David-Andrino/iot-power/README.md

# IoT - POWER

**David Andrino** 

**Estela Mora** 

**Fernando Sanz** 

**Hugo Sanchez**

Gemini_Generated_Image_dmnvikdmnvikdmnv
