David-Andrino/iot-power/memoria/files/3-Software/3-2-Modulos Software/3-2-2-Fichero_Hardware.tex

\subsubsection{Fichero Hardware.h}

El fichero \texttt{Hardware.h} define los pines que utiliza el \texttt{ESP}. 

Siendo estos pines:
\begin{itemize}
    \item \textbf{GPIO13 y GPIO15}: Para la gestión de la conmutación de los relés. 
    \item \textbf{GPIO4 y GPIO5}: Usados para la gestión de la comunicación \texttt{I2C} (Señales \texttt{SDA} y \texttt{SCL} respectivamente). 
\end{itemize}
