David-Andrino/iot-power/doxygen/main.md

# IoT - POWER

**David Andrino**

**Estela Mora**

**Fernando Sanz**

**Hugo Sánchez**

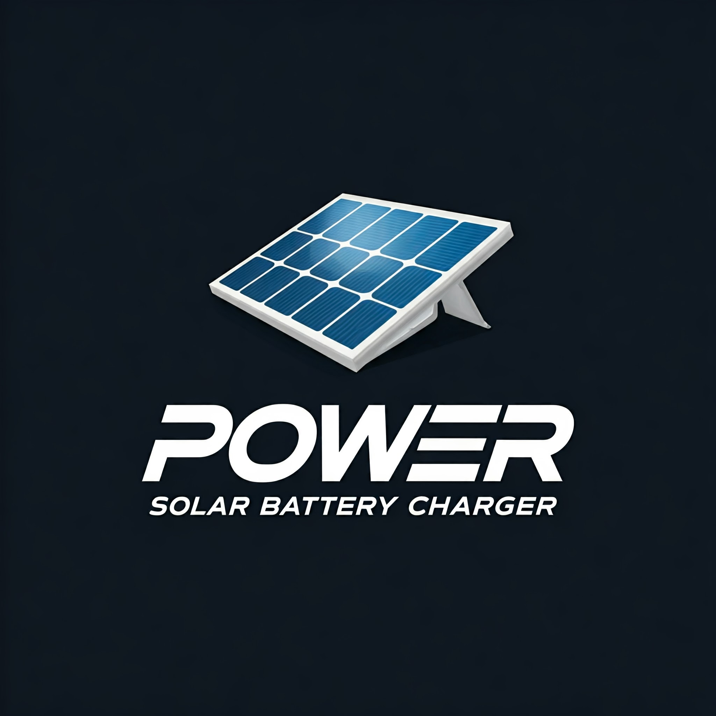
[picture p10: doxygen/logo_full.jpg]
