David-Andrino/iot-power/memoria/cover.tex

\begin{titlepage}
    \raggedleft
    \rule{1pt}{\textheight}
    \hspace{0.05\textwidth}
    \parbox[b]{0.9\textwidth}{
            {\Huge\bfseries POWER}\\[\baselineskip] % Title
            {\Large\textit{Photovoltaic Optimized Wireless Energy Recharger}}\\[7\baselineskip] % Subtitle or further description
        \vspace{0.45\textheight}
        
        {\Large\textsc{David Andrino}}\\[0.5\baselineskip]
        {\Large\textsc{Estela Mora}}\\[0.5\baselineskip]
        {\Large\textsc{Hugo Sánchez}}\\[0.5\baselineskip]
        {\Large\textsc{Fernando Sanz}}\\
        \vspace{0.05\textheight}
        
        {\noindent\large Hardware para IoT}\\
        {\noindent\large Otoño 2024}\\
    }

\end{titlepage}
