David-Andrino/iot-power/memoria/files/3-Software/3-3-Programa Principal/Programa Principal.tex

Este módulo está formado por el archivo, \texttt{MAIN\_POWER.ino} que se encarga de conectar todos los módulos en un sistema unificado.

Inicialmente, en la cabecera del fichero se incluyen las librerías que vamos a utilizar:
\begin{itemize}
    \item \texttt{telemetry.hpp}: Define la estructura de datos que será usada para almacenar las lecturas recibidas por los \texttt{INA}.
    \item \texttt{hardware-hpp}: Define los pines del \texttt{ESP} que son necesarias para el funcionamiento del sistema (I2C y relés).
    \item \texttt{ina.hpp}: Contiene el código relativo a la gestión, configuración y obtención de datos de los \texttt{INA}. 
    \item \texttt{mqtt\_client.hpp}: Contiene el código relativo a la conexión y envío de datos al servidor \texttt{MQTT}.
    \item \texttt{file\_management.hpp}: Contiene el código relativo a la escritura en un fichero de los datos recibidos de los \texttt{INA}.
    \item \texttt{sleep.hpp}: Contiene el código que pone en bajo consumo al \texttt{ESP}.
\end{itemize}

\begin{lstlisting}[captionpos=b, caption={Cabecera con los módulos y ficheros utilizados}, language=c++]
#include "telemetry.hpp"
#include "hardware.hpp"
#include "ina.hpp"
#include "mqtt_client.hpp"
#include "file_management.hpp"
#include "sleep.hpp"
\end{lstlisting}

A continuación, se define una macro para imprimir mensajes de depuración por \texttt{Serial}, si la variable \texttt{DEBUG} está definida.
\begin{lstlisting}[captionpos=b, caption={Definición de la macro de depuración}, language=c++]
#define DEBUG

#ifdef DEBUG
#define PRINT_DEBUG(...) Serial.println(__VA_ARGS__)
#else
#define PRINT_DEBUG(...)
#endif    
\end{lstlisting}

Esta macro se encarga de escribir por el puerto serie información de interés como:
\begin{itemize}
    \item Mostrar la información recibida por los \texttt{INA} (así corroborar la correcta recepción en el \texttt{MQTT}).
    \item Indicar si se ha podido enviar correctamente los datos al servidor \texttt{MQTT}.
    \item Indicar la hora recibida del \texttt{NTP}.
    \item Indicar la correcta conexión con la red \texttt{Wi-Fi}.
    \item Indicar si se ha podido escribir correctamente en el fichero que almacena los datos de medidas.
    \item Indicar el estado del proceso de conexión con la \texttt{WiFi}.
    \item Indicar las modificaciones en los relés y el estado en el que se encuentran.
\end{itemize}

Después de este código, se encuentra la definición de distintos elementos utilizados por el \texttt{main}:
\begin{lstlisting}[captionpos=b, caption={Constantes de \texttt{MAIN\_POWER}}, language=c++]
#define ssid             "POC"
#define password         "POWERIoT"

#define MQTT_SERVER      const_cast<char*>("192.168.111.69")
#define MQTT_PORT        4444

#define TIME_SLEEP       10000
#define WIFI_TRIES       35
#define BAT_THRESH       11.8
#define SOLAR_THRESH     20
#define MEASUREMENT_FILE "/measurements.txt"
\end{lstlisting}

\begin{itemize}
    \item \texttt{SSID y password}: Son utilizados para indicar el \texttt{SSID} de la Wi-Fi a la que conectarse y su contraseña. 
    \item \texttt{MQTT\_SERVER y MQTT\_PORT}: Indican la dirección y el puerto del servidor \texttt{MQTT} al que el \texttt{ESP} se intentará conectar para enviar datos.
    \item \texttt{TIME\_SLEEP}: Indica el tiempo en ms que se quedará en bajo consumo/dormido el sistema.
    \item \texttt{WIFI\_TIRES}: Indica el número de reintentos que damos al \texttt{ESP} para conectarse a la red \texttt{Wi-Fi}.
    \item \texttt{BAT\_THRESH}: Umbral de la batería de backup con el que el sistema determina si activa la protección de sobrecarga.
    \item \texttt{SOLAR\_THRESH}: Umbral del panel solar para el que el sistema determina si cambiamos a la carga mediante la batería de backup.
    \item \texttt{MEASUREMENT\_FILE}: Indica la ruta donde se almacena el fichero de medidas.
\end{itemize}

El fichero contiene las siguientes funciones:

\begin{itemize}
\item \texttt{setup()}: Inicializa los pines que usamos para la comunicación \texttt{I2C} y los relés, la velocidad del puerto serie y el valor inicial de la estructura de datos que contienen.

\begin{lstlisting}[captionpos=b, caption={Codigo de la funcion \texttt{setup}}, language=c++]
void setup() {
    pinMode(RELAY_SW_IN,  OUTPUT);
    pinMode(RELAY_SW_OUT, OUTPUT);
    pinMode(SDA,          OUTPUT);
    pinMode(SCL,          OUTPUT);

    Serial.begin(9600);
}    
\end{lstlisting}

\item \texttt{loop()}: Bucle principal de funcionamiento del sistema. La secuencia de ejecución es la siguiente:
\begin{enumerate}
    \item Recoge las medidas de los \texttt{INA}.
    \item Revisa los valores obtenidos de tensión y actúa sobre los relés.
    \item Se intenta conectar a la red \texttt{Wi-Fi}. Si lo consigue se intenta mandar las medidas al servidor \texttt{MQTT}.
    \item Guarda las medidas de los sensores en un fichero.
    \item Duerme al \texttt{ESP} poniéndolo en bajo consumo.
    \item Sale del modo de bajo consumo.
\end{enumerate}

\begin{lstlisting}[captionpos=b, caption={Codigo de la funcion \texttt{loop}}, language=c++]
measureINA226(&telemetry);

PRINT_DEBUG("[INA] VSolar [V]:  " + String(telemetry.VSolar));
PRINT_DEBUG("[INA] ISolar [mA]: " + String(telemetry.ISolar));
PRINT_DEBUG("[INA] VBatbu [V]:  " + String(telemetry.VBatbu));
PRINT_DEBUG("[INA] IBatbu [mA]: " + String(telemetry.IBatbu));
PRINT_DEBUG("[INA] VBat1 [V]:   " + String(telemetry.VBat1));
PRINT_DEBUG("[INA] IBat1 [mA]:  " + String(telemetry.IBat1));
PRINT_DEBUG("[INA] VBat2 [V]:   " + String(telemetry.VBat2));
PRINT_DEBUG("[INA] IBat2 [mA]:  " + String(telemetry.IBat2));

setRelays(&telemetry);

setup_wifi();

if (WiFi.status() == WL_CONNECTED){
    configTime(3600, 0, "time.nist.gov", "0.pool.ntp.org");
    
    if (!publishTelemetry(MQTT_SERVER, MQTT_PORT, telemetry)){
        PRINT_DEBUG("[POWER] ERROR publicando medidas");
    } else {
        PRINT_DEBUG("[POWER] Medidas publicadas con exito");
    }

    getLocalTime(&currentTime, 1000);
    strftime(timeStr, 50, "[%d/%m/%y - %H:%M:%S]", &currentTime);
    PRINT_DEBUG("[WIFI] Sincronizado con NTP. Hora obtenida: " + String(timeStr));
} else {
    PRINT_DEBUG("[WIFI] No se ha podido conectar a la red WiFi");
    snprintf(timeStr, 50, "[00/00/00 - 00:00:00]");
}

if (write_meas(MEASUREMENT_FILE, telemetry, timeStr)){
    PRINT_DEBUG("[POWER] Fichero escrito con exito");
} else {
    PRINT_DEBUG("[POWER] El fichero no ha podido ser escrito");
}

sleep_low_power(TIME_SLEEP);
\end{lstlisting}

La primera secuencia que hay en el código es \texttt{measureINA226(\&telemetry);} función tiene una ligera limitación, si los \texttt{INA} no están conectados el sistema se queda bloqueado.
Esto ocurre ya que se queda a la espera de una respuesta de la dirección \texttt{I2C} del \texttt{INA} al que está llamando, que en caso de no estar configurado, se quedará el sistema bloqueado hasta esa respuesta o un \texttt{reset}.

Tras recibir las medidas, si nos encontramos depurando el código, podremos observar por el puerto serie los datos que han sido almacenados de cada elemento del circuito.

Una vez leídas las medidas, el sistema verifica los valores de tensión del panel solar y de la batería y modifica los relés en función de estos.
En caso de que no se supere un valor mínimo de tensión tanto del panel solar como de la batería de \textit{backup}, el sistema activaría la protección de sobredescarga para evitar daños en el sistema. 
Entrar en este modo implicaría que las funciones del \texttt{ESP} dejarían de estar disponibles hasta que las tensiones superen los umbrales, alimentando una vez más al \texttt{ESP} y volviendo a su funcionamiento normal.

Tras esto, se intenta la conexión con la red \texttt{Wi-Fi}:
\begin{itemize}
    \item No se consigue conectar a la \texttt{Wi-Fi}: Se establece la hora y fecha de las medidas realizadas a 0 y no se intenta enviar los datos al servidor \texttt{MQTT}. 
    \item Si se consigue conectar a la \texttt{Wi-Fi}: Se configura un servidor \texttt{NTP} para asegurar la fecha y hora en las que realizan las medidas. Tras esto se intenta enviar los datos leídos al servidor \texttt{MQTT}.
\end{itemize}

Independientemente de si se ha podido conectar a la \texttt{Wi-Fi} o no, se intenta realizar una escritura con las lecturas realizadas en el fichero de medidas.

Finalmente, tras realizar todas las operaciones anteriores, se pone a dormir el \texttt{ESP} durante un tiempo \texttt{TIME\_SLEEP}. Tras esto el sistema se vuelve a activar y a realizar las operaciones de nuevo.

\begin{figure}[H]
    \centering
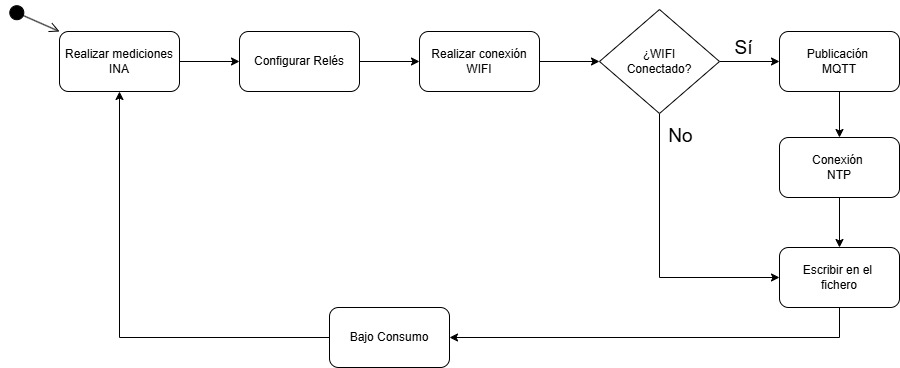
[picture p19: memoria/images/3-software/3-3-programaprincipal/DiagramaDeFlujoPOWER.jpg]
    
    \caption{Diagrama de flujo Programa Principal}
    \label{fig:3-3-1-DiagramaFlujo}
\end{figure}
\end{itemize}

Para la implementación del programa principal, también se han desarrollado dos funciones adicionales que se encargan de intentar la conexión \texttt{Wi-Fi} y configurar los relés del sistema. A continuación, se explican dichas funciones:

\begin{itemize}
    \item Función \texttt{setup\_wifi()}: esta función es la encargada de la conexión \texttt{Wi-Fi} del sistema. Se intentará la conexión un número determinado de intentos, definidos en la variable \texttt{WIFI\_TRIES}. Esta función no recibe ningún parámetro y tampoco devuelve nada.
    \begin{lstlisting}[captionpos=b, caption={Definición función setup\_wifi}, language=c++]
        static void setup_wifi();
    \end{lstlisting}
    La secuencia de ejecución de esta función es la siguiente:
    \begin{enumerate}
        \item Muestra por serial un mensaje con la red \texttt{Wi-Fi} a la que se intenta la conexión.
        \item Intenta realizar la conexión a la red \texttt{Wi-Fi} con las credenciales almacenadas en las variables \texttt{ssid} y \texttt{password}. Estas variables almacenan el nombre de la red \texttt{Wi-Fi} y su correspondiente contraseña, respectivamente.
        \item Se intenta realizar la conexión un número finito de intentos indicados en la variable

        \texttt{WIFI\_TRIES}. El tiempo de espera entre intentos de conexión es de $500\ ms$.
        \item En caso de que la conexión haya sido satisfactoria, el sistema mostrará por serial un mensaje al usuario indicando que la conexión \texttt{Wi-Fi} se ha realizado correctamente. En este mensaje se mostrará el nombre de la red a la que se ha realizado la conexión y la dirección \texttt{IP} de nuestro dispositivo \texttt{ESP8266}.
        \item Por otra parte, en caso de que el sistema no haya sido capaz de conectarse a la red \texttt{Wi-Fi} indicada, se mostrará un mensaje de error por serial indicando al usuario la conexión fallida.
    \end{enumerate}
    \begin{lstlisting}[captionpos=b, caption={Desarrollo función \texttt{setup\_wifi}}, language=c++]
static void setup_wifi() {
    delay(10);
    Serial.print("[WIFI] Intentando conectar a " ssid);
    WiFi.begin(ssid, password);
    for (int i = 0; i < WIFI_TRIES && WiFi.status() != WL_CONNECTED; i++) {
        delay(500);
        Serial.print(".");
        i++;
    }
    if (WiFi.status() == WL_CONNECTED) {
        PRINT_DEBUG("[WIFI] Conectado a la red WiFi " ssid " con IP: ");
        PRINT_DEBUG(WiFi.localIP());
    } else {
        PRINT_DEBUG("[WIFI] No se ha podido conectar a la red WiFi");
    }
}
    \end{lstlisting}
    \item Función \texttt{setRelays}: esta función es la encargada de configurar los relés del sistema en función de los valores medidos por los sensores y de los valores almacenados en las variables \texttt{SOLAR\_THRESH} y \texttt{BAT\_THRESH}. Esta función recibe como parámetro un puntero a la variable \texttt{telemetry}, la cual almacena las medidas obtenidas por los diferentes sensores y no devuelve nada.
    \begin{lstlisting}[captionpos=b, caption={Definición función \texttt{setRelays}}, language=c++]
static void setRelays(telemetry_t *telemetry);
    \end{lstlisting}
    Esta función se compone de tres casos para las diferentes posibilidades de funcionamiento del sistema. Estas opciones son las siguientes:
    \begin{itemize}
        \item VSolar $>$ \texttt{SOLAR\_THRESH}: esta posibilidad se refleja cuando la tensión medida en el panel solar es mayor al valor del \texttt{threshold} solar, almacenado en dicha variable. Esto quiere decir que la energía aportada por el panel solar es suficiente para asegurar el correcto funcionamiento y cargar de forma adecuada tanto la batería de backup como las otras dos baterías de carga. En este caso, ambos relés están en la posición que hemos denominado \texttt{LOW}, conectando el panel solar como entrada de energía y habilitando la carga de la batería de \textit{Backup}.
        \item VBatbu $>$ \texttt{BAT\_THRESH}: en caso de que la tensión medida en el panel solar no sea suficiente para alimentar el circuito completo, se comprobará si la energía almacenada en la batería de backup es suficiente. Para ello, se compara la tensión medida en dicha batería con su respectivo \texttt{threshold}, almacenado en la variable \texttt{BAT\_THRESH}. En caso de que dicha tensión medida sea mayor, quiere decir que es suficiente para asegurar el correcto funcionamiento del sistema y la carga correcta de las otras dos baterías. Para este caso, los relés conmutan a la posición denominada \texttt{HIGH}, la cual desconecta el panel solar del sistema y conecta la batería de backup al camino de alimentación del sistema.
        \item Por último, en caso de que la tensión solar no sea suficiente y la batería de \textit{Backup} se descargue hasta el umbral, se debe para la descarga de la batería para protegerla, por lo que los relés volverán a la posición inicial (\texttt{LOW}) pero debido a que no hay alimentación suficiente, el sistema se apagará. El sistema permanecerá en este estado hasta que el panel solar vuelva a su funcionamiento nominal y pueda aportar la cantidad de energía suficiente para volver al comportamiento predeterminado del sistema, cargando tanto la batería de backup como las otras 2 baterías de carga. 
    \end{itemize}
    \begin{lstlisting}[captionpos=b, caption={Desarrollo función \texttt{setRelays}}, language=c++]
static void setRelays(telemetry_t *telemetry){
    if (telemetry->VSolar > SOLAR_THRESH) {
        PRINT_DEBUG("[RELAY] Panel solar activo");

        digitalWrite(RELAY_SW_IN,LOW);
        digitalWrite(RELAY_SW_OUT,LOW);
    } else if (telemetry->VBatbu > BAT_THRESH){
        PRINT_DEBUG("[RELAY] Bateria backup activa");

        digitalWrite(RELAY_SW_IN,HIGH);
        digitalWrite(RELAY_SW_OUT,HIGH);
    } else {
        PRINT_DEBUG("[RELAY] Activando proteccion sobredescarga. Se detendra el sistema");

        digitalWrite(RELAY_SW_IN,LOW);
        digitalWrite(RELAY_SW_OUT,LOW);
    }
}
    \end{lstlisting}
\end{itemize}
