David-Andrino/iot-power/memoria/files/2-Hardware/Modulos/baterias.tex

\subsubsection{Baterías}

Para las baterías, se van a elegir unas baterías de plomo ácido. Estas tienen una tensión nominal de $12\ V$ y una capacidad de $7\ Ah$. Estas son baterías típicamente utilizadas para herramientas de potencia como las que serían objetivo del caso de uso del sistema.
