David-Andrino/iot-power/memoria/files/2-Hardware/Modulos/panelSolar.tex

\subsubsection{Panel Solar}

El panel solar elegido será explicado en el \autoref{subsec:panel_solar}.
