David-Andrino/iot-power/memoria/structure.md

# Introducción (Enunciado y caso de uso)

# Desarrollo Hardware
## Diagrama de bloques
## Módulos individuales (Caracterización)
### Módulo de reducción de consumo de relés (Cosecha propia)
### Medidor de tensión y corriente: INA226
### Cargador de baterías: CN3768
### Controlador de descarga: PS58F1
### Convertidor reductor: LM2596
### Convertidor elevador: XL6009
### Regulador lineal: AMS1117
### Baterías
### Panel solar
## Montaje completo

# Desarrollo Software
## Librerías utilizadas
## Arquitectura de la solución
### Implementación en ESP8266
### Implementación en Thingsboard
## Documentación software (Doxygen)

# Desarrollo teórico
## Caja
## Panel solar

# Presupuesto
# Horas totales realizadas

# Bibliografía
