David-Andrino/iot-power/memoria/files/6-Horas.tex

\section{Horas dedicadas al proyecto}
En la \autoref{tab:horas} se pueden ver las principales tareas en las que se ha dividido el proyecto y las horas que han tomado cada una.
\begin{table}[H]
    \centering
    \begin{tabular}[c]{llr}
        \toprule
        \textbf{Integrante} & \textbf{Tareas} & \multicolumn{1}{c}{\textbf{Horas}} \\ \midrule

        \textbf{David}      & Diseño de sistema electrónico         & 7 \\
                            & Selección de componentes electrónicos & 2 \\ 
                            & Caracterización de componentes        & 5 \\
                            & Diseño de PCB de relés                & 5 \\
                            & Montaje de prototipo electrónico      & 50 \\ 
                            & Depuración de circuito electrónico    & 40 \\
                            & Memoria                               & 20 \\
                            \midrule

        \textbf{Estela}     & Diseño de sistema electrónico         & 7 \\
                            & Compra de componentes                 & 2 \\
                            & Caracterización de componentes        & 5 \\
                            & Diseño de PCB de relés                & 5 \\
                            & Montaje de prototipo electrónico      & 50 \\ 
                            & Depuración de circuito electrónico    & 40 \\
                            & Memoria                               & 20 \\
                            \midrule

        \textbf{Hugo}       & Búsqueda librerías compatibles con \texttt{INA}                   & 3   \\
                            & Código \texttt{INA}                                               & 3   \\
                            & Código \texttt{Wi-Fi/MQTT} en Arduino                             & 7   \\
                            & Pruebas de los módulos individuales de programación               & 4   \\
                            & Regulación y ajuste de los \texttt{INA}                           & 2   \\
                            & Desarrollo de la caja en \texttt{3D}                              & 10  \\
                            & Análisis de características y requisitos de protección de la caja & 15  \\
                            & Memoria                                                           & 16  \\ \midrule

        \textbf{Fernando}   & Investigación \texttt{ThingsBoard}                                & 1   \\
                            & Instalación \texttt{ThingsBoard}                                  & 2   \\
                            & Desarrollo bajo consumo                                           & 2   \\
                            & Desarrollo programa principal                                     & 3   \\
                            & Software gestión ficheros                                         & 2   \\
                            & Pruebas módulos software y \texttt{ThingsBoard}                   & 5   \\
                            & Investigación panel solar                                         & 4   \\
                            & Memoria                                                           & 10  \\ \midrule

        \textbf{Total}      &                                                                   & \textbf{350} \\ \bottomrule

    \end{tabular}
\caption{Distribución de horas dedicadas al proyecto}
\label{tab:horas}
\end{table}

Como se puede ver en la tabla, se han dedicado muchas más horas de las estimadas inicialmente (200). Esto es debido principalmente a la elevada complejidad del circuito electrónico y la alta cantidad de componentes que interconectar, caracterizar y probar.
