David-Andrino/iot-power/memoria/files/AnexoCaja.tex

\section{Perspectivas de la caja}\label{sec:anexo_caja}

\begin{figure}[H]
	\centering
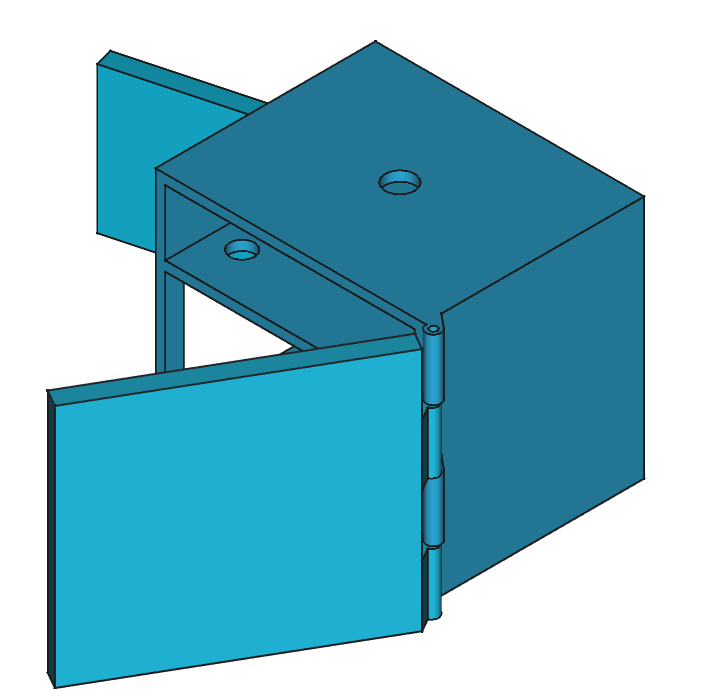
[picture p27: memoria/images/4-DesarrolloTeorico/4-1-caja/CAJA_3D_ISOMETRICA_2.png]
	
	\caption{Vista isométrica}
\end{figure}

\begin{figure}[H]
	\centering
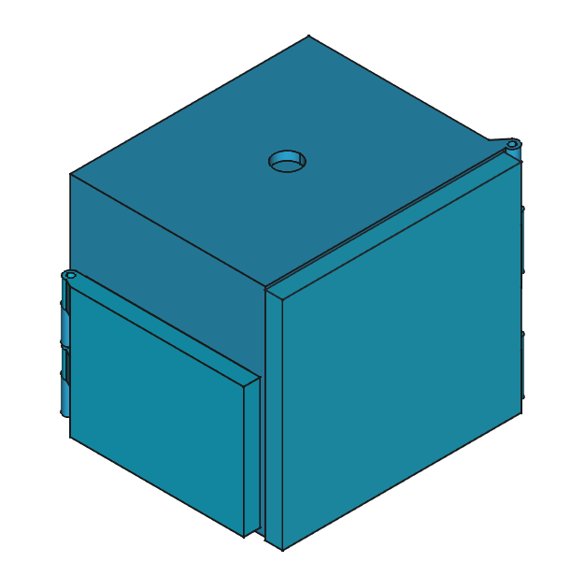
[picture p28: memoria/images/4-DesarrolloTeorico/4-1-caja/CAJA_3D_CERRADA.png]
	
	\caption{Caja Cerrada}
\end{figure}

\begin{figure}[H]
	\centering
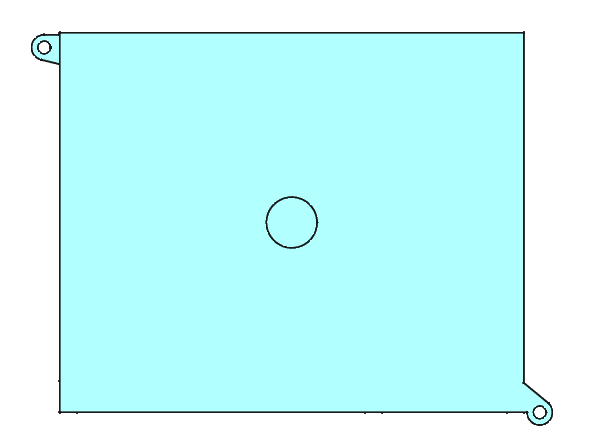
[picture p29: memoria/images/4-DesarrolloTeorico/4-1-caja/CAJA_3D_ARRIBA.png]
	
	\caption{Vista parte superior de la caja}
\end{figure}

\begin{figure}[H]
	\centering
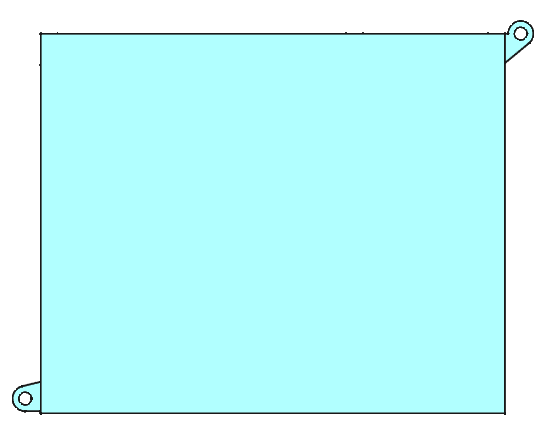
[picture p30: memoria/images/4-DesarrolloTeorico/4-1-caja/CAJA_3D_ABAJO.png]
	
	\caption{Vista parte inferior de la caja}
\end{figure}

\begin{figure}[H]
	\centering
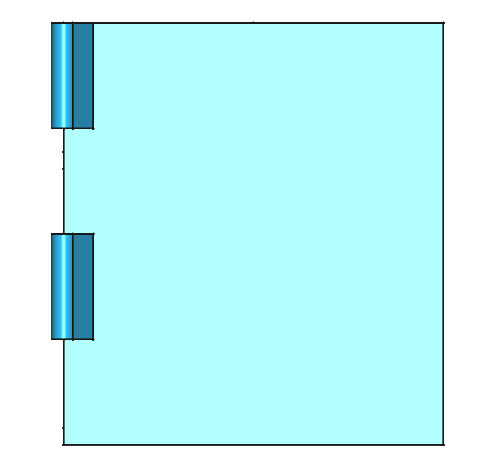
[picture p31: memoria/images/4-DesarrolloTeorico/4-1-caja/CAJA_3D_DER.png]
	
	\caption{Vista parte derecha de la caja}
\end{figure}

\begin{figure}[H]
	\centering
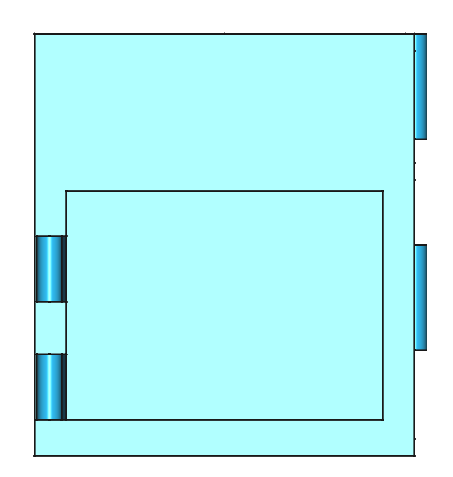
[picture p32: memoria/images/4-DesarrolloTeorico/4-1-caja/CAJA_3D_IZQ.png]
	
	\caption{Vista parte izquierda de la caja}
\end{figure}

\begin{figure}[H]
	\centering
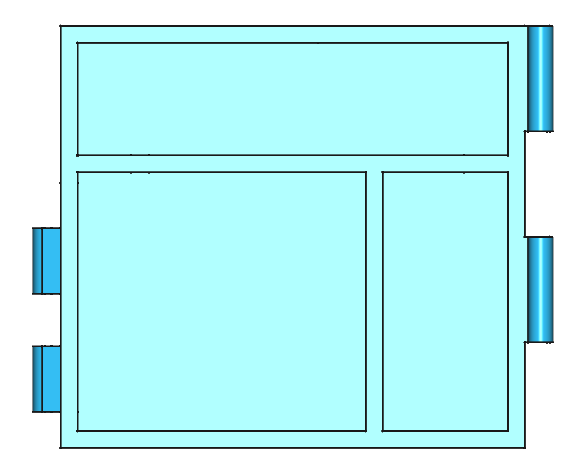
[picture p33: memoria/images/4-DesarrolloTeorico/4-1-caja/CAJA_3D_FRONTAL.png]
	
	\caption{Vista parte frontal de la caja}
\end{figure}

\begin{figure}[H]
	\centering
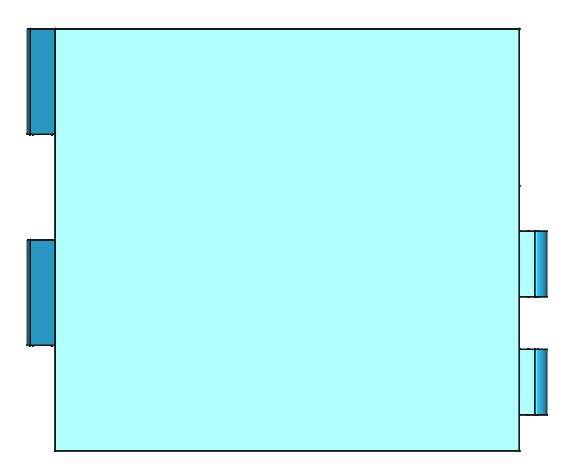
[picture p34: memoria/images/4-DesarrolloTeorico/4-1-caja/CAJA_3D_ATRAS.png]
	
	\caption{Vista parte de atrás de la caja}
\end{figure}
