David-Andrino/iot-power/memoria/files/3-Software/3-1-Interfaz Usuario/3-1-1-Thingsboard.tex

Para la visualización y representación de los distintos valores de tensión y corriente medidos por los diferentes sensores, se ha optado por utilizar \texttt{ThingsBoard}, una plataforma IoT de código abierto para la recopilación, el procesamiento, la visualización y la gestión de dispositivos de datos.

\begin{figure}[H]
    \centering
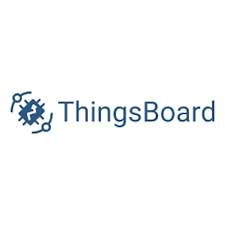
[picture p35: memoria/images/3-software/3-2-2-thingsboard/LogoThingsboard.png]
    
    \caption{Plataforma \texttt{ThingsBoard}}
    \label{fig:3-2-2-ThingsBoard}
\end{figure}

Para su instalación en el ordenador, se ha optado utilizar una máquina virtual en VirtualBox mediante la imagen de un servidor Linux con distribución Ubuntu. Para la realización de dicha instalación se ha seguido la guía oficial de la plataforma de \texttt{ThingsBoard}, que se puede definir en los siguientes pasos: \cite{thingsboardInstallingThingsBoardCE}

\begin{enumerate}
    \item Instalar \texttt{Java17} y configurarlo como predeterminado mediante los comandos:
    \begin{verbatim}
sudo apt update
sudo apt install openjdk-17-jdk
sudo update-alternatives --config java
    \end{verbatim}

    \item Instalar \texttt{ThingsBoard} mediante los siguientes comandos:
    \begin{verbatim}
wget https://github.com/thingsboard/thingsboard/releases/\
download/v3.8.1/thingsboard-3.8.1.deb
sudo dpkg -i thingsboard-3.8.1.deb
    \end{verbatim}

    \item Configurar la base de datos de \texttt{ThingsBoard}:
    \begin{verbatim}
sudo apt install -y postgresql-common
sudo /usr/share/postgresql-common/pgdg/apt.postgresql.org.sh
sudo apt -y install postgresql-16
sudo service postgresql start
sudo su - postgres
psql
    \end{verbatim}
    A continuación, elige tu contraseña del \texttt{postgres} mediante el siguiente comando:
    \begin{verbatim}
\password
    \end{verbatim}
    Después pulsa ``Ctrl + D'' para volver atrás y utiliza el siguiente comando para conectarte a la base de datos \texttt{postgres}:
    \begin{verbatim}
psql -U postgres -d postgres -h 127.0.0.1 -W
    \end{verbatim}
    Ahora, crea la base de datos para \texttt{ThingsBoard} mediante el comando: \\
    \texttt{CREATE DATABASE thingsboard;} \\
    Por último, pulsa dos veces ``Ctrl + D'' para salir del \texttt{PostgreSQL}.

    \item Modificar el archivo de configuración de \texttt{ThingsBoard} mediante el siguiente comando:
    \begin{verbatim}
sudo nano /etc/thingsboard/conf/thingsboard.conf
    \end{verbatim}
    A continuación, añade estas líneas al final del archivo y no olvides cambiar \\
    \texttt{PUT\_YOUR\_POSTGRESQL\_PASSWORD\_HERE} por la contraseña del \texttt{postgres} que pusiste anteriormente:
    \begin{verbatim}
# DB Configuration
export DATABASE_TS_TYPE=sql
export SPRING_DATASOURCE_URL=jdbc:postgresql://localhost:5432/thingsboard
export SPRING_DATASOURCE_USERNAME=postgres
export SPRING_DATASOURCE_PASSWORD=PUT_YOUR_POSTGRESQL_PASSWORD_HERE
# Specify partitioning size for timestamp key-value storage.
# Allowed values: DAYS, MONTHS, YEARS, INDEFINITE.
export SQL_POSTGRES_TS_KV_PARTITIONING=MONTHS
    \end{verbatim}

    \item Elegir el tipo de servicio de cola de \texttt{ThingsBoard}. En este caso se elige el caso por defecto, en memoria, por lo que no es necesario ningún paso adicional.

    \item Ejecutar el script de instalación mediante el siguiente comando:
    \begin{verbatim}
sudo /usr/share/thingsboard/bin/install/install.sh --loadDemo
    \end{verbatim}

    \item Arrancar el servicio de \texttt{ThingsBoard} mediante el siguiente comando:
    \begin{verbatim}
sudo service thingsboard start
    \end{verbatim}
\end{enumerate}

Una vez realizados estos pasos, se podrá acceder a \texttt{ThingsBoard} en la siguiente dirección: 

\texttt{http://<IP VM>:8080/}

Por defecto, \texttt{ThingsBoard} incluye tres diferentes perfiles para acceder a la plataforma:
\begin{itemize}
    \item \textit{System Administrator}: \texttt{sysadmin@thingsboard.org / sysadmin}
    \item \textit{Tenant Administrator}: \texttt{tenant@thingsboard.org / tenant}
    \item \textit{Customer User}: \texttt{customer@thingsboard.org / customer}
\end{itemize}

Debido al uso de la máquina virtual, se ha tenido que realizar una redirección de los puertos mediante la interfaz de red de la propia máquina, obteniendo la siguiente configuración:

\begin{figure}[H]
    \centering
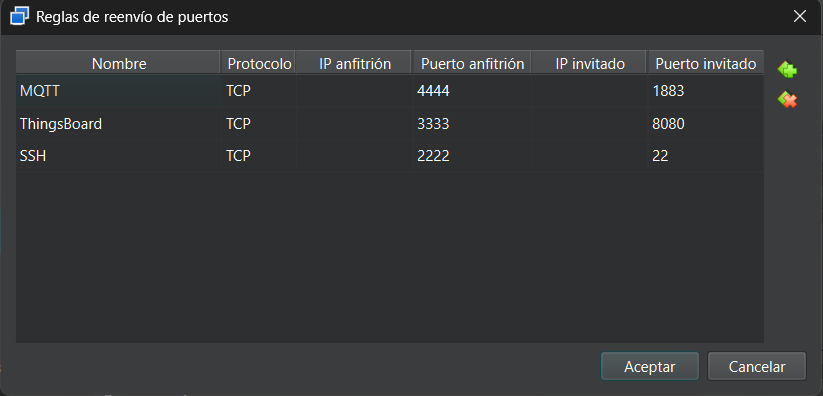
[picture p36: memoria/images/3-software/3-2-2-thingsboard/PuertosMV.png]
    
    \caption{Redirección de puertos MV}
    \label{fig:3-2-2-PuertosMV}
\end{figure}

Por lo que, en nuestro caso, el puerto 1883 del \texttt{MQTT Broker} se corresponde con el puerto 4444 del anfitrión (\textit{host}), el puerto 3333 del anfitrión se corresponde con el puerto 8080 de la máquina virtual y también se ha redirigido el puerto 22 de \texttt{SSH} al puerto 2222 de la máquina anfitriona.

Para la comunicación entre la plataforma \texttt{ThingsBoard} y el dispositivo \texttt{ESP8266}, utilizamos un \texttt{Broker MQTT} \textit{OpenSource} ampliamente utilizado debido a su ligereza, lo que permite fácilmente emplearlo en gran número de ambientes, incluso si estos son de pocos recursos. A continuación se indica el comando necesario para su instalación, obtenido de la guía oficial de \texttt{ThingsBoard}: \cite{thingsboardMQTTDeviceAPI}

\begin{verbatim}
sudo apt-get install mosquitto-clients
\end{verbatim}

Para comprobar que todo se ha realizado correctamente, se puede utilizar el siguiente comando:
\begin{verbatim}
mosquitto_pub -d -q 1 -h "$THINGSBOARD_HOST_NAME" -p "1883"
-t "v1/devices/me/telemetry" -u "$ACCESS_TOKEN" -m {"ATTRIBUTE":25}
\end{verbatim}

Donde los siguientes parámetros corresponden con:
\begin{itemize}
    \item \texttt{THINGSBOARD\_HOST\_NAME}: dirección IP del servidor \texttt{ThingsBoard}, \\
    por ejemplo, \texttt{localhost} o \texttt{127.0.0.1}.
    \item \texttt{ACCESS\_TOKEN}: token de acceso único proporcionado por \texttt{ThingsBoard} para cada dispositivo.
    \item \texttt{ATTRIBUTE}: atributo asociado a dicho dispositivo, por ejemplo, \texttt{temperature}.
\end{itemize}

En caso de que la conexión y publicación se haya realizado de manera correcta, se obtendrá la siguiente respuesta:
\begin{verbatim}
Client mosqpub|xxx sending CONNECT
Client mosqpub|xxx received CONNACK
Client mosqpub|xxx sending PUBLISH
(d0, q1, r0, m1, 'v1/devices/me/telemetry', ... (16 bytes))
Client mosqpub|xxx received PUBACK (Mid: 1)
Client mosqpub|xxx sending DISCONNECT
\end{verbatim}

Una vez que se ha comprobado el correcto funcionamiento de la conexión entre la plataforma \texttt{ThingsBoard} y el \texttt{broker} y cliente \texttt{MQTT}, se puede continuar con la personalización de dicha plataforma.

Para la visualización de los datos recibidos, se ha optado por diseñar dos paneles o \textit{Dashboards}, uno en representación en forma de tablas y otro en forma de gráficas. Ambos paneles se actualizan en tiempo real y cuentan con una tabla o gráfica para cada dispositivo, obtenido un total de 4 tablas y 4 gráficas. Además, en las gráficas se puede visualizar también la media de los últimos datos medidos.

\begin{figure}[H]
    \centering
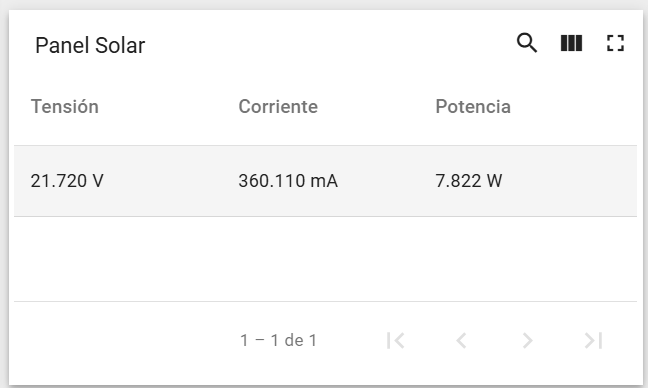
[picture p37: memoria/images/3-software/3-2-2-thingsboard/TablaThingsBoard.png]
    
    \caption{Tabla de medidas}
    \label{fig:3-2-2-TablaThingsBoard}
\end{figure}

\begin{figure}[H]
    \centering
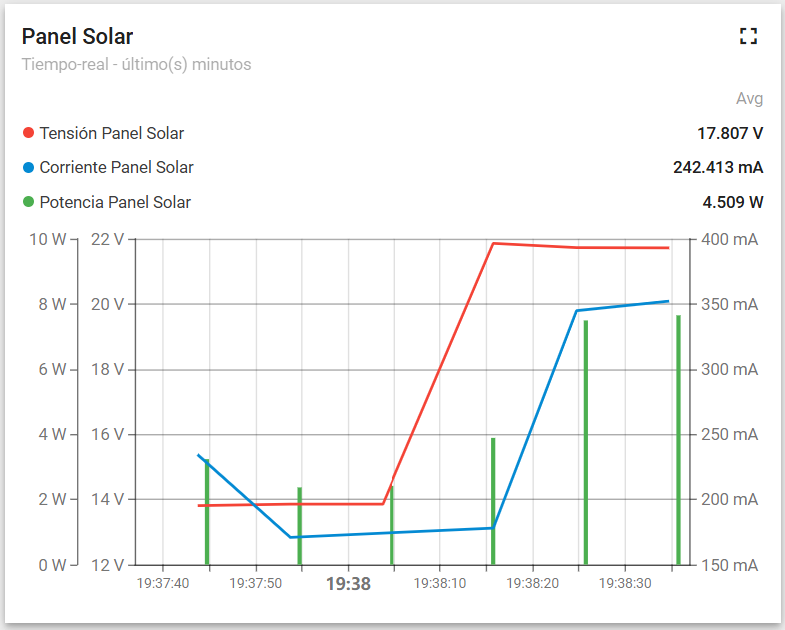
[picture p38: memoria/images/3-software/3-2-2-thingsboard/GraficaThingsBoard.png]
    
    \caption{Gráfica de medidas}
    \label{fig:3-2-2-GraficaThingsBoard}
\end{figure}

Debido a que mediante los sensores solo se obtienen valores de tensión y de corriente, se ha implementado un algoritmo mediante las cadenas de reglas de \texttt{ThingsBoard}. Se ha necesitado crear una cadena de reglas para cada potencia calculada, obteniendo 4 cadenas de reglas como la siguiente:

\begin{figure}[H]
    \centering
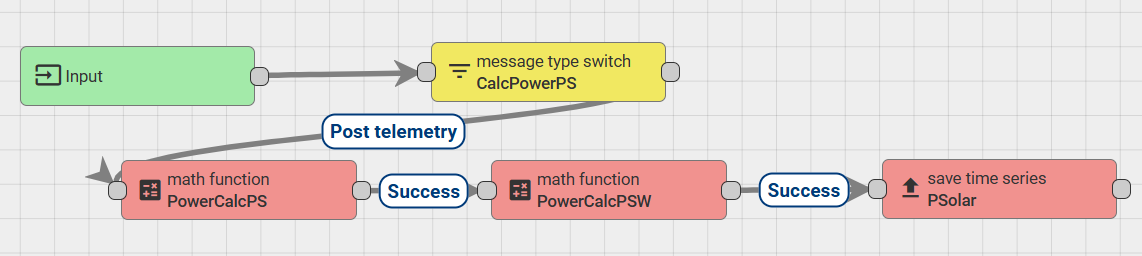
[picture p39: memoria/images/3-software/3-2-2-thingsboard/CadenaPotencia.png]
    
    \caption{Cadena de reglas para cálculo de potencias}
    \label{fig:3-2-2-CadenaPotenciaThingsBoard}
\end{figure}

Dichas cadenas de reglas se dividen en los siguientes pasos:

\begin{enumerate}
    \item Filtrar y transformar la telemetría entrante
    \item Realizar el cálculo de la potencia correspondiente
    \item Pasar dicha potencia a Vatios
    \item Guardas los valores para su representación
\end{enumerate}

Por último, se ha añadido dichas cadenas de reglas de potencia a la cadena de regla principal, la cual gestiona el funcionamiento completo de \texttt{ThingsBoard} y permite visualizar el dato obtenido de su respectiva cadena de regla.

\begin{figure}[H]
    \centering
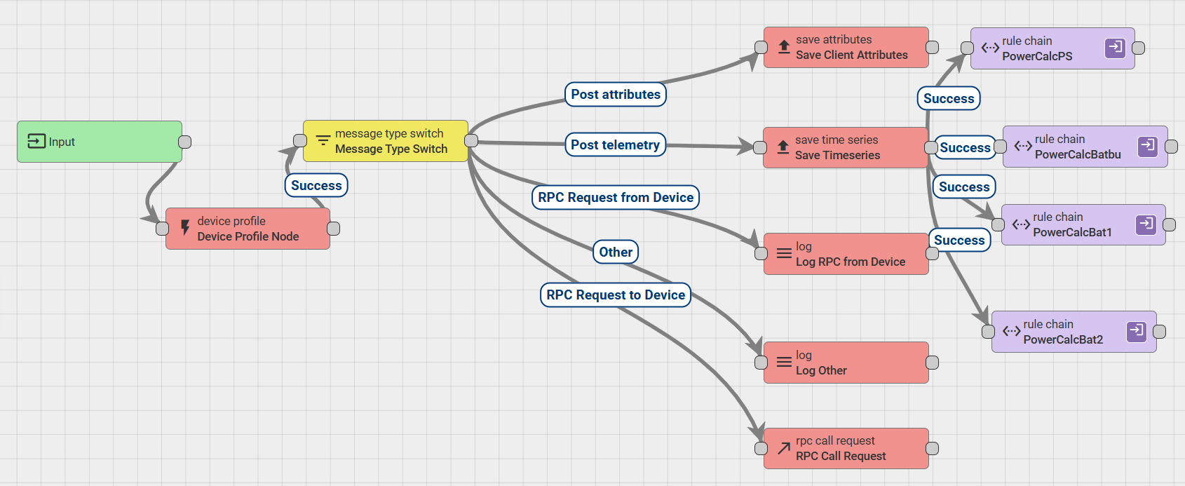
[picture p40: memoria/images/3-software/3-2-2-thingsboard/CadenaPrincipal.png]
    
    \caption{Cadena de reglas principal}
    \label{fig:3-2-2-CadenaPrincipalThingsBoard}
\end{figure}

Después de realizar los pasos descritos anteriormente, se han añadido las gráficas correspondientes a todas las medidas obtenidas en la página de gráficas del \texttt{ThingsBoard}, al igual que sus correspondientes tablas de valores instantáneos en la página de tablas, obteniendo las siguientes interfaces:
\begin{figure}[H]
    \centering
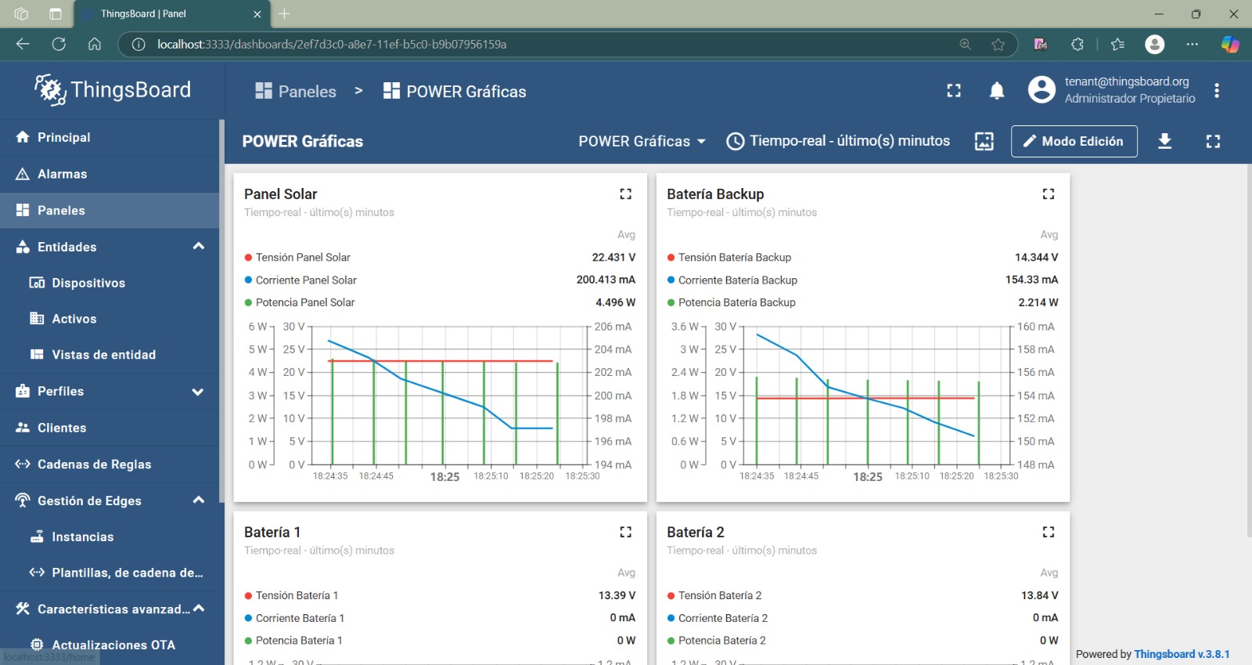
[picture p41: memoria/images/3-software/3-2-2-thingsboard/PaginaGraficas.jpg]
    
    \caption{Página de gráficas \texttt{ThingsBoard}}
    \label{fig:3-2-2-PaginaGraficasThingsBoard}
\end{figure}

\begin{figure}[H]
    \centering
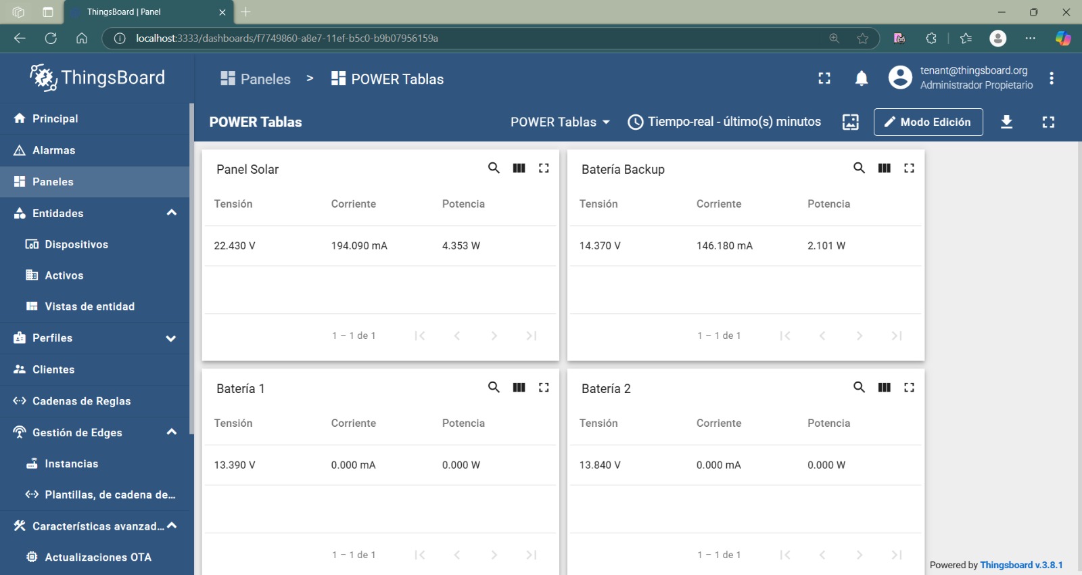
[picture p42: memoria/images/3-software/3-2-2-thingsboard/PaginaTablas.jpg]
    
    \caption{Página de tablas \texttt{ThingsBoard}}
    \label{fig:3-2-2-PaginaTablasThingsBoard}
\end{figure}

De esta forma, se obtiene una interfaz para visualizar los valores instantáneos en las tablas de las medidas obtenidas por los sensores a la par que se puede visualizar los valores históricos en las gráficas.
