David-Andrino/iot-power/memoria/files/3-Software/3-2-Modulos Software/3-2-5-Bajo_Consumo.tex

El módulo de bajo consumo es el encargado de reducir el consumo del sistema cuando no es necesario que funcione a plena potencia, es decir, entre las obtenciones de las diferentes medidas.

Las librerías incluidas con el \texttt{ESP8266} incluye un modo de bajo consumo ya definido llamado \texttt{deep-sleep}, el cual desactiva el \texttt{Wi-Fi}, el reloj del sistema y la \texttt{CPU}, es decir, solo mantiene el funcionamiento del \texttt{RTC} y reduce el consumo del sistema a apenas unas decenas de microamperios. Sin embargo, debido a que este modo de bajo consumo inhabilita también los \texttt{GPIO} es incompatible con nuestro sistema, ya que si se activara, el sistema no sería capaz de mantener los relés conmutados al entrar a este modo. Debido a esto, este modo de bajo consumo no es apto para nuestro sistema. \cite{esp8266ESP8266LowPower}

\begin{figure}[H]
    \centering
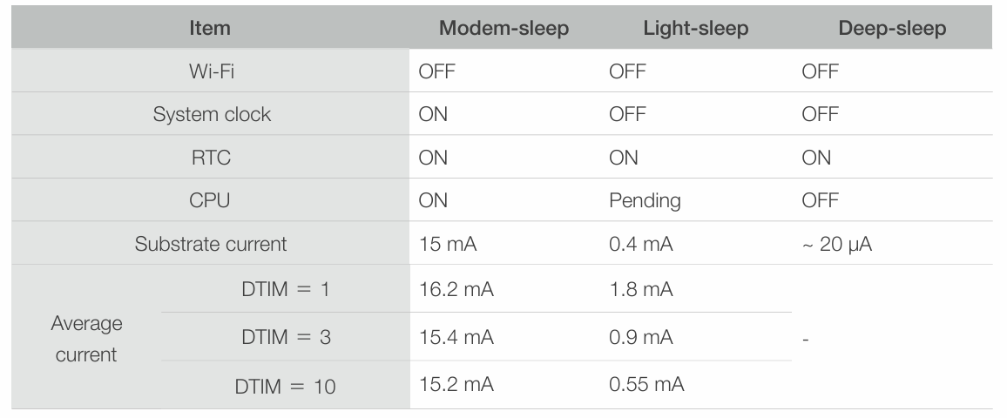
[picture p44: memoria/images/3-software/3-2-5-lowpower/Modos Bajo Consumo.png]
    
    \caption{Modos Bajo Consumo ESP8266}
    \label{fig:3-2-5-1-ModosBajoConsumo}
\end{figure}

Por este requisito, hemos desarrollado nuestro propio modo de bajo consumo, el cual reduce el consumo del sistema en un $80\%$ aproximadamente. Este modo de bajo consumo es similar al llamado \texttt{modem-sleep}. Por nuestra parte, nuestro modo desactiva el \texttt{Wi-Fi}, baja la frecuencia del reloj del sistema y ejecuta un \texttt{delay}, para que el micro reduzca su consumo. Ya que en ningún momento se inhabilitan los \texttt{GPIO}, este modo de bajo consumo es perfecto para nuestro sistema.

Este módulo está dividido en dos ficheros, \texttt{sleep.hpp} el cual contiene la definición de la función de bajo consumo y la importación de la librería necesaria, y el fichero \texttt{sleep.cpp}, el cual contiene la implementación de dicha función, que recibe como parámetro el tiempo en milisegundos deseado de duración del modo de bajo consumo y no devuelve nada.

\begin{lstlisting}[captionpos=b, caption={Función bajo consumo}, language=c++]
    void sleep_low_power(int time_delay) {}
\end{lstlisting}

La secuencia de ejecución se puede dividir en dos secuencias consecutivas, una que activa el modo de bajo consumo y otra que restaura el funcionamiento normal. La secuencia de activación es la siguiente:

\begin{enumerate}
    \item Se desactiva el módulo de \texttt{Wi-Fi}, activando el modo \texttt{Wi-Fi\_OFF}.
    \item Se llama a la función \texttt{forceSleepBegin()}, la cual guarda el modo de \texttt{Wi-Fi} actual y fuerza el estado de modo \texttt{sleep} del \texttt{Wi-Fi}, reduciendo aún más el consumo.
    \item Se reduce la frecuencia del reloj del sistema al mínimo valor posible, $80$ MHz.
    \item Se introduce un \texttt{delay}. Esto asegura que el microprocesador consumirá menos durante dicho tiempo, además se utiliza para definir la duración aproximada del modo de bajo consumo.
\end{enumerate}

\begin{lstlisting}[captionpos=b, caption={Activación modo bajo consumo}, language=c++]
Serial.println("[SLEEP] Entrando en modo bajo consumo");
WiFi.mode(WIFI_OFF);
WiFi.forceSleepBegin();
system_update_cpu_freq(SYS_CPU_80MHZ);

delay(time_delay);
\end{lstlisting}

Una vez pasado el tiempo definido de bajo consumo, se entra en la secuencia de restauración, la cual consta de los siguientes pasos:

\begin{enumerate}
    \item Aumentar la frecuencia del reloj al valor anterior, 160 MHz.
    \item Forzar la activación del módulo del \texttt{Wi-Fi}.
    \item Aplicar un \texttt{delay} de $1\ ms$ para asegurar que el módulo \texttt{Wi-Fi} se haya despertado.
    \item Configurar el módulo de \texttt{Wi-Fi} como una estación, es decir, configurar el \texttt{ESP8266} como un dispositivo que se conecta a un punto de acceso.
\end{enumerate}

\begin{lstlisting}[captionpos=b, caption={Restauración modo bajo consumo}, language=c++]
Serial.println("[SLEEP] Saliendo del modo bajo consumo");
system_update_cpu_freq(SYS_CPU_160MHZ);
WiFi.forceSleepWake();
delay(1);
WiFi.mode(WIFI_STA);
\end{lstlisting}

Mediante la implementación de nuestro propio modo de bajo consumo, nos aseguramos que correcto funcionamiento durante y después de dicho modo, reduciendo el consumo del sistema un $80\%$ aproximadamente, pasando de un consumo de $73\  mA$ aproximadamente a pleno funcionamiento, a apenas $15\ mA$ en el estado de bajo consumo.
