David-Andrino/iot-power/memoria/images/2-hardware/bloquesEspecifico.png

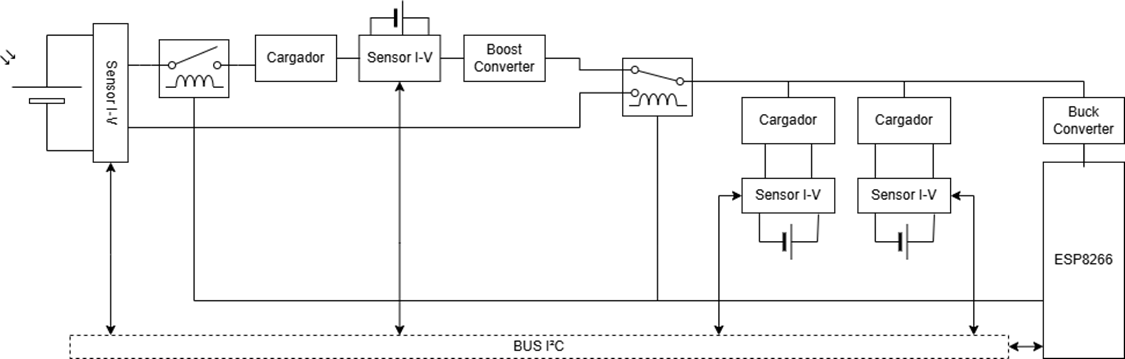
memoria/images/2-hardware/bloquesEspecifico.png
