David-Andrino/iot-power/memoria/images/2-hardware/Estados.png

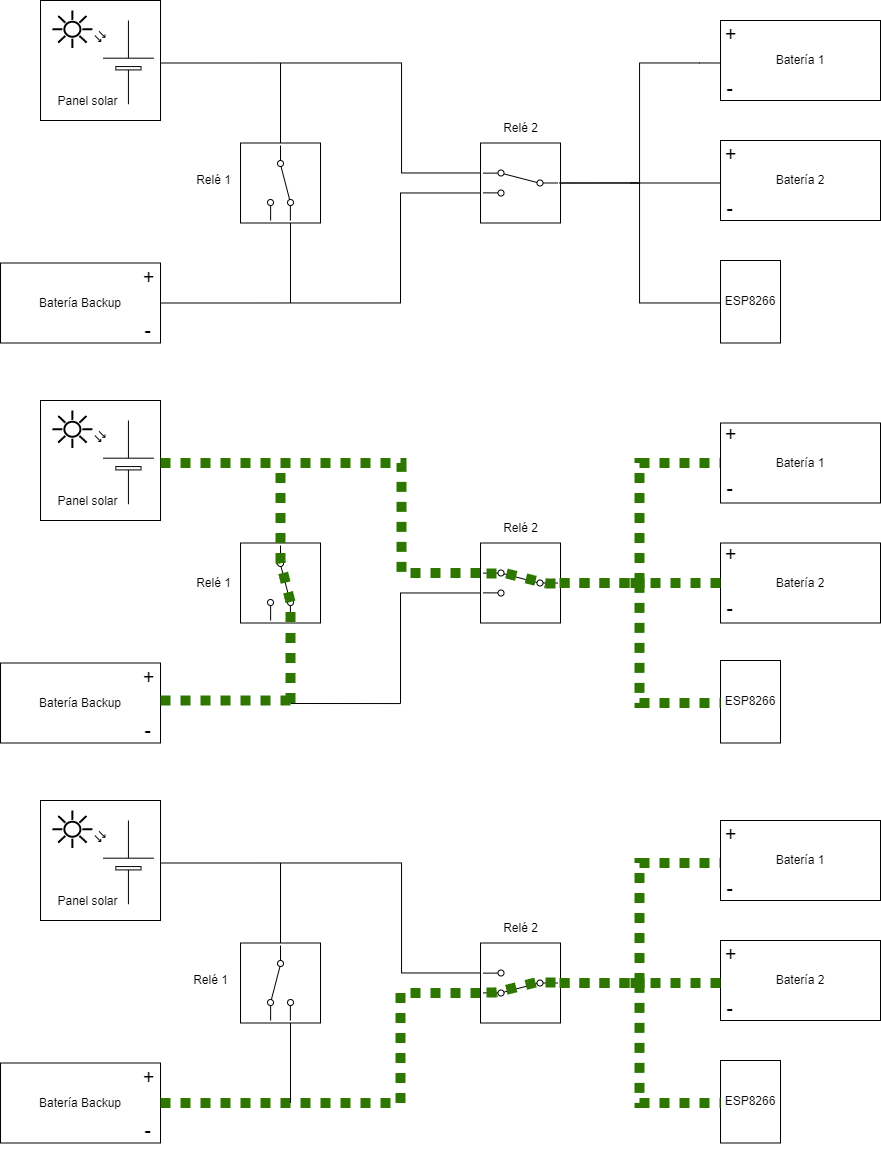
memoria/images/2-hardware/Estados.png
