David-Andrino/iot-power/memoria/images/2-hardware/ganttEstimado.png

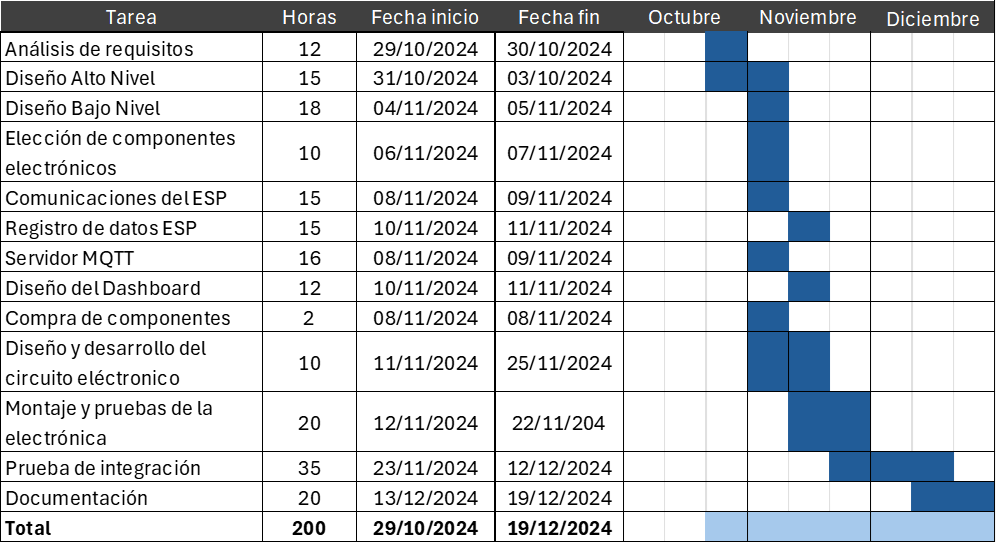
memoria/images/2-hardware/ganttEstimado.png
