David-Andrino/iot-power/memoria/images/2-hardware/screwTerminal.png

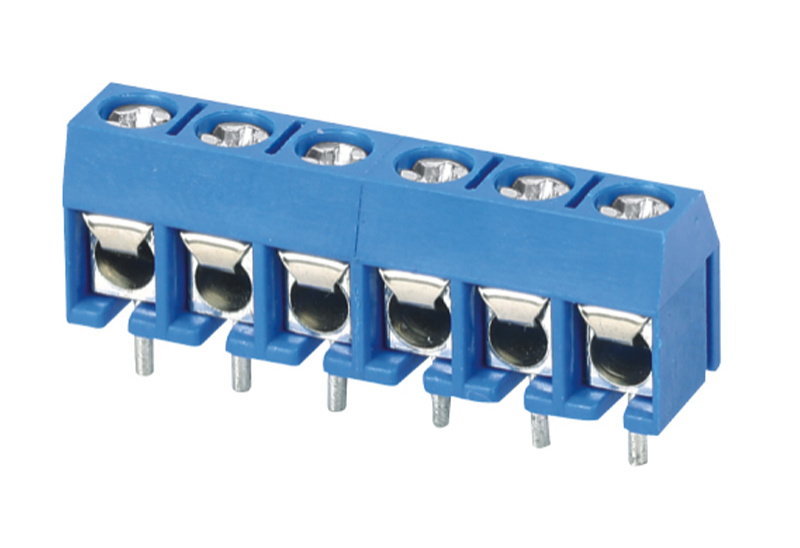
memoria/images/2-hardware/screwTerminal.png
