David-Andrino/iot-power/memoria/images/3-software/3-2-1-ina/INA_INSTANCIA.jpg

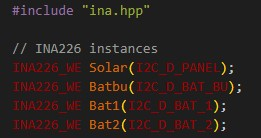
memoria/images/3-software/3-2-1-ina/INA_INSTANCIA.jpg
