David-Andrino/iot-power/memoria/images/3-software/3-2-1-mqtt/MQTT_PUB.jpg

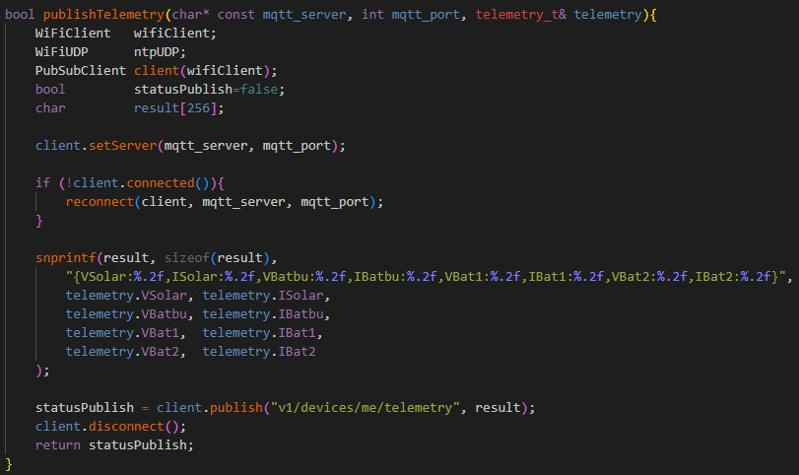
memoria/images/3-software/3-2-1-mqtt/MQTT_PUB.jpg
