David-Andrino/iot-power/memoria/files/2-Hardware/2-3-MontajeCompleto.tex

\subsection{Sistema completo}\label{subsec:montaje_completo}

\input{files/2-Hardware/Montaje/bloquesSimples.tex}

\input{files/2-Hardware/Montaje/conexionado.tex}

\input{files/2-Hardware/Montaje/estados.tex}

\input{files/2-Hardware/Montaje/esquematico.tex}

\input{files/2-Hardware/Montaje/montajeCompleto.tex}
