David-Andrino/iot-power/esquematico-circuito/Output/Diagrama.pdf

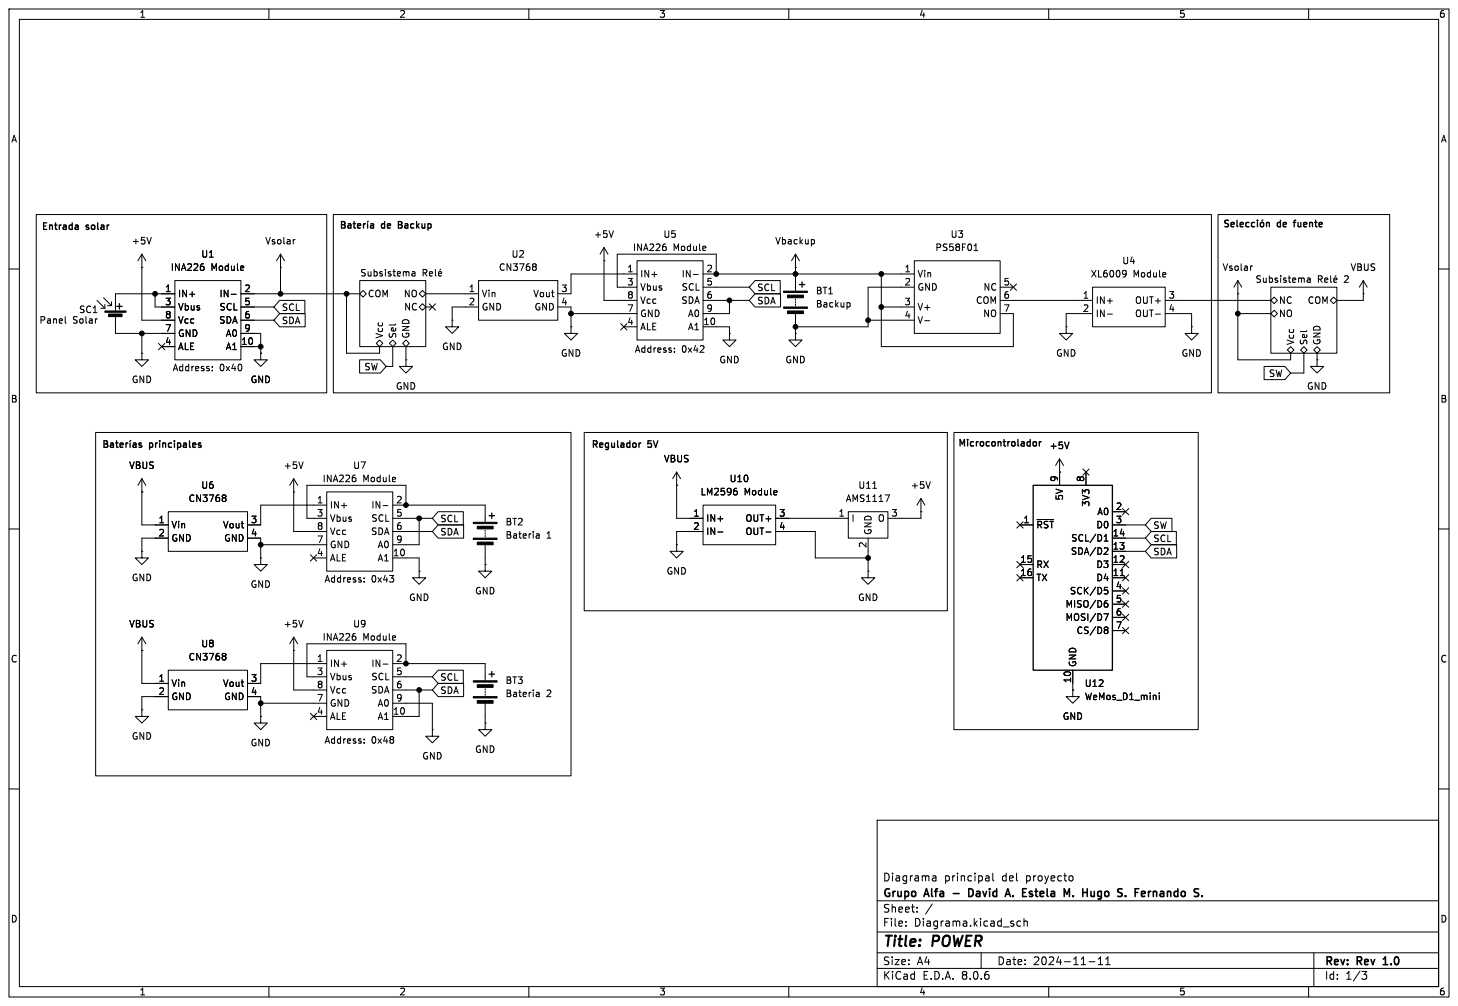
[picture p74: page 1]

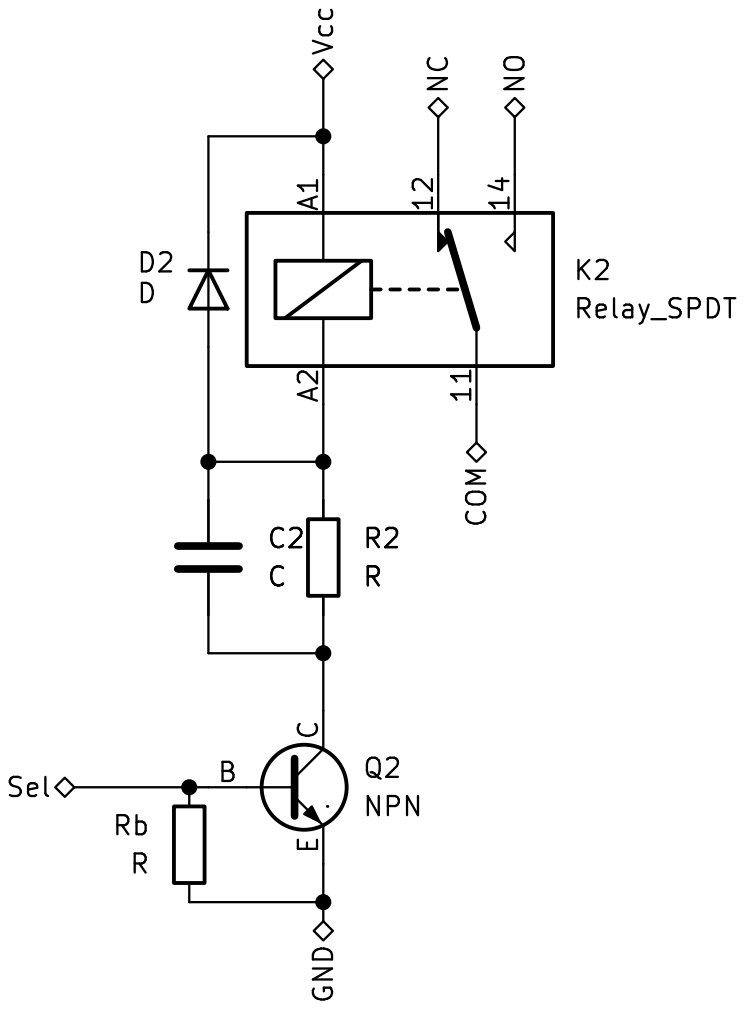
[picture p75: page 2]

E Q2 NPN Sel COM Vcc NCNO GND

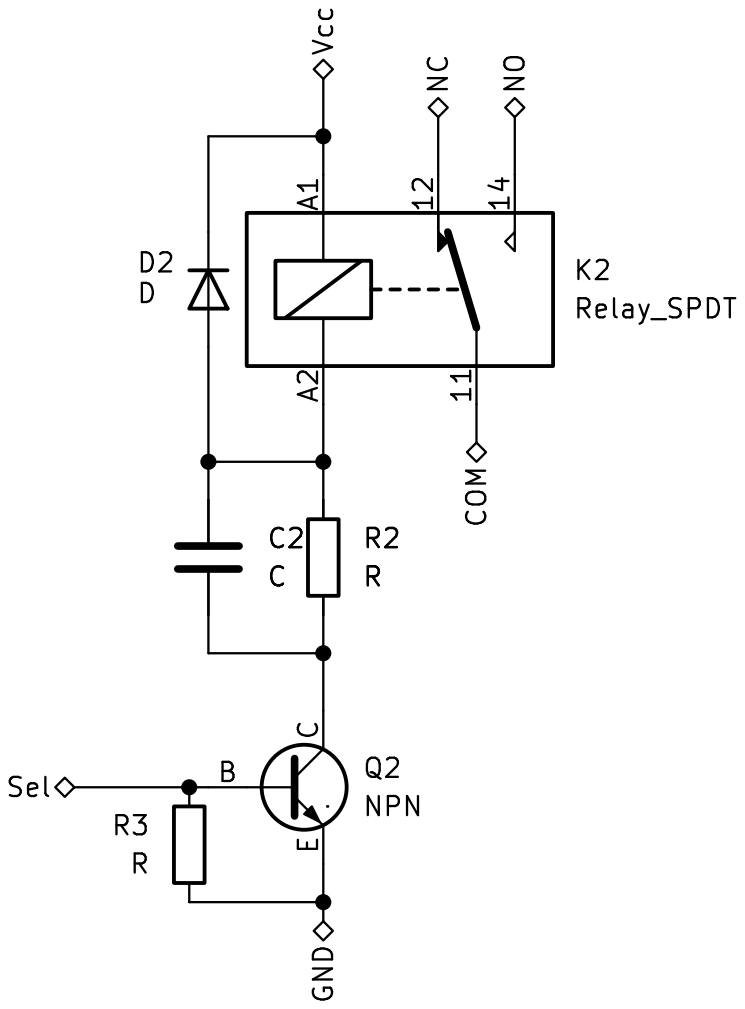
[picture p76: page 3]

E Q2 NPN Sel COM Vcc NCNO GND
