David-Andrino/iot-power/circuito-rele/circuito.kicad_pcb

## KiCad design circuito-rele/circuito.kicad_pcb (2024-12-30)

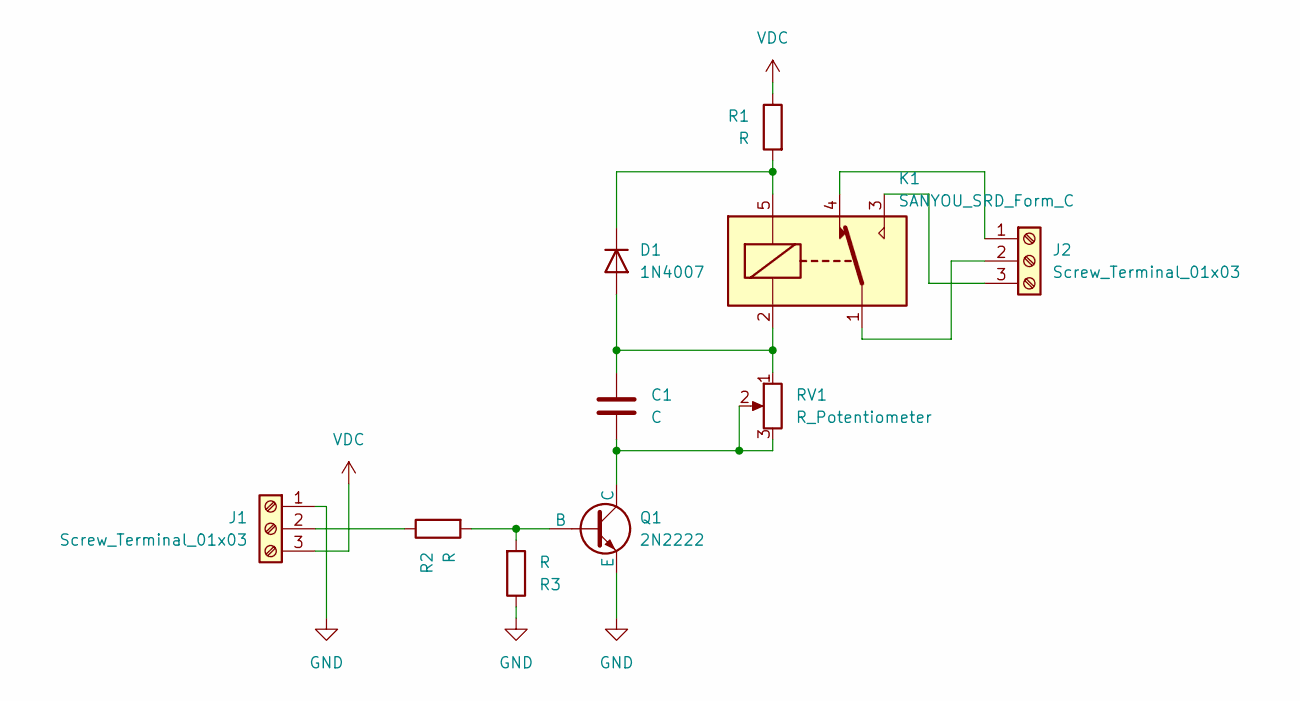
[picture p77: schematic circuito.kicad_sch]

Parts:
C1: C; CP_Radial_D12.5mm_P5.00mm
D1: 1N4007; D_DO-41_SOD81_P10.16mm_Horizontal
J1, J2: Screw_Terminal_01x03; TerminalBlock_bornier-3_P5.08mm
K1: SANYOU_SRD_Form_C; Relay_SPDT_SANYOU_SRD_Series_Form_C
Q1: 2N2222; TO-92L_HandSolder
R1, R2, R3: R; R_Axial_DIN0207_L6.3mm_D2.5mm_P10.16mm_Horizontal
RV1: R_Potentiometer; Potentiometer_ACP_CA9-V10_Vertical_Hole

Connections:
GND: J1.1, Q1.3 (E), R3.1
unnamed: C1.1, D1.2 (A), K1.2, RV1.1
unnamed: D1.1 (K), K1.5, R1.2
unnamed: J1.2, R2.1
unnamed: J2.1, K1.4
unnamed: J2.2, K1.1
unnamed: J2.3, K1.3
unnamed: Q1.2 (B), R2.2, R3.2
unnamed: C1.2, Q1.1 (C), RV1.2, RV1.3
VDC: J1.3, R1.1

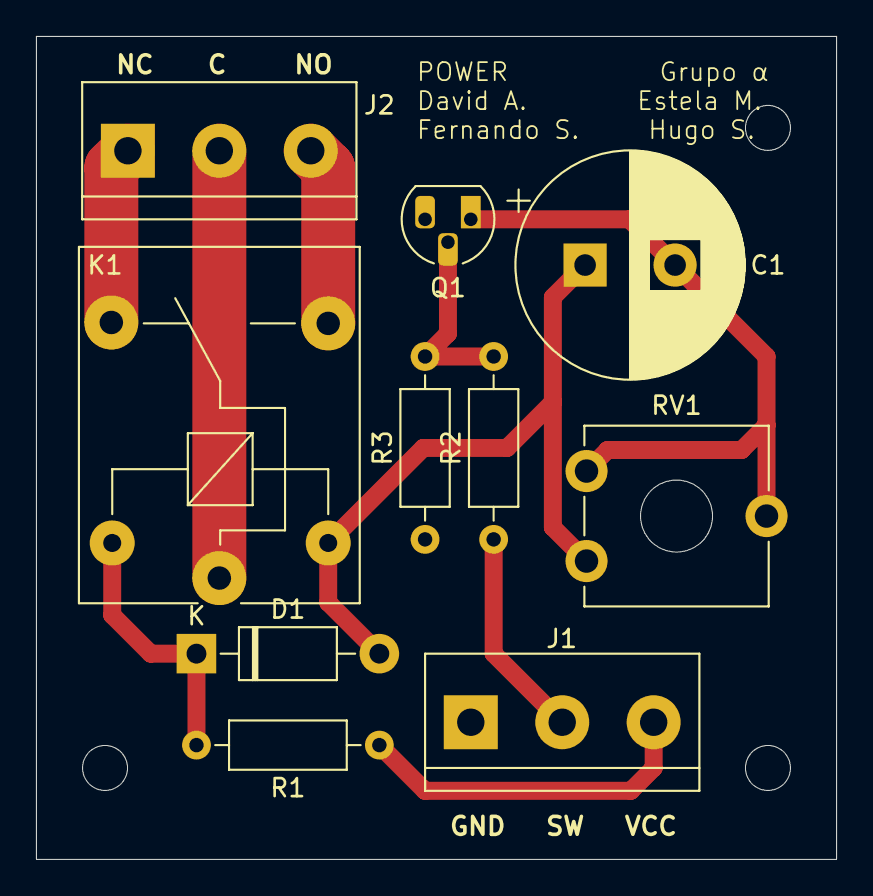
[picture p78: board circuito.kicad_pcb from above]

Board: 2 copper layers, 44.5 x 45.7 mm, 10 parts (0 on the bottom side), 10 nets.
