David-Andrino/iot-power/(commit log)

2024-11-08 Limpieza de archivos
2024-11-08 Actualizar el main
2024-11-08 Main
    Pendiente de modificarlo para añadir las cosas de fer
2024-11-19 Crear diagrama
    [circuito.kicad_pcb, circuito.kicad_sch]
2024-11-19 Terminar circuito
    [bom.csv, circuito.kicad_pcb, circuito.kicad_sch, designators.csv, positions.csv]
2024-11-19 Cambiar nombre de carpeta de circuito de rele
    [bom.csv, circuito.kicad_pcb, circuito.kicad_sch, designators.csv, positions.csv]
2024-11-22 Grueso del código
    Fichero con el código terminado, quedan pendientes pruebas y hacer las medidas con cada dirección SPI.
2024-11-22 Envios Correctos
    Cambios para el envío al MQTT al topic correcto.
2024-11-22 Metodo de publicacion de medidas arreglado
2024-11-27 Medidas_INA_Funcionando
    Pendiente Cambiar Direcciones INA para que corresponda con cada uno de los módulos
2024-11-29 Modularizar y comentar el codigo
2024-11-30 Medidas_Bajo_Consumo
    Medidas a petición (cambiar el loop por un metodo cunado lo juntemos todo) y tras las medidas bajo consumo
2024-12-04 Bajo Consumo + Modularizado + Documentado+ Test
    -Documentación:
    Fuente de la librería Arduino: https://github.com/wollewald/INA226_WE?tab=readme-ov-file
    Ejemplos de código:https://wolles-elektronikkiste.de/en/ina226-current-and-power-sensor
2024-12-04 Crear workflow de Doxygen
2024-12-08 Organizar la memoria
2024-12-12 Add RTC, write file and sleep in Main Power
2024-12-12 Corrección error conexion MQTT
    [mqtt_client.cpp]
2024-12-12 Añadidas las direcciones de los INA
2024-12-13 Crear estructura de submodulos hardware en la memoria
2024-12-15 Cambiar nombre de .h a .hpp y separar telemetry.hpp
2024-12-15 Cambiar nombres de ina y file_management. Unificar write y read en uno
2024-12-15 Ponerle nombre a los pines de los reles
2024-12-15 Refactorizar el main
2024-12-15 Añadir comentarios para el Doxygen
2024-12-15 Arreglar comentario de telemetry.hpp
    [telemetry.hpp]
2024-12-17 Modulo de descarga
2024-12-17 Módulo cargador de baterías
2024-12-21 Cambiar estructura de la memoria
2024-12-23 Parte de memoria del panel solar
2024-12-23 Programa de lectura memoria
2024-12-23 Diagrama de bloques general actualizado
2024-12-23 Circuito reles
2024-12-24 Caracterizacion de componentes
2024-12-25 Foto del PCB de los reles
2024-12-25 Añadir diagrama de flujo programa pincipal
2024-12-26 Diagrama de estados
2024-12-26 Añadir esquematico del circuito
    [Diagrama.kicad_pcb, Diagrama.kicad_sch, rele.kicad_sch]
2024-12-26 Explaination of battery protection
2024-12-28 Tabla de las horas
2024-12-29 Elevadisima precision de los INA
2024-12-29 Encarecida recomendacion de pcb analogica
2024-12-29 Cambiar PIN por GPIO en 3.2.2
2024-12-29 Hacer los todo de mis partes
2024-12-30 Memoria 1.3 Anexo de código
